Joujo1/behaviour_bmi/bmi_closed_loop/bin_viewer.py

#!/usr/bin/env python3
"""
Standalone .bin file viewer for BMI closed-loop recordings.

Opens a browser-based file browser rooted at NAS_BASE_PATH.
Select any .bin file to view a Verilog-style waveform of all GPIO signals,
with state/substage annotations and a small JPEG preview.

Usage:
    python bin_viewer.py [--port 7000] [--root /path/to/NAS]

Then open http://localhost:7000 in a browser.
"""

import argparse
import io
import json
import os
import struct
import sys

from flask import Flask, abort, jsonify, make_response, render_template, request, send_file

# ── Packet format (must match udp_sender_pi.py and packet_parser.py) ─────────

HEADER_FORMAT = "<IQIIBBBBBBBBB"
HEADER_SIZE   = struct.calcsize(HEADER_FORMAT)
HEADER_FIELDS = [
    "pi_seq", "timestamp", "jpeg_size", "events_size",
    "led_center", "led_left", "led_right",
    "valve_left", "valve_right",
    "beam_left", "beam_right", "beam_center",
    "trial_state",
]

GPIO_SIGNALS = [
    ("led_left",    "LED L",   False),
    ("led_center",  "LED C",   False),
    ("led_right",   "LED R",   False),
    ("beam_left",   "Beam L",  True),
    ("beam_center", "Beam C",  True),
    ("beam_right",  "Beam R",  True),
    ("valve_left",  "Valve L", False),
    ("valve_right", "Valve R", False),
    ("clicks",      "Clicks",  False),
]

# ── Bin file indexing ─────────────────────────────────────────────────────────

def index_bin(path: str) -> tuple:
    """
    Parse headers and events for every frame.
    Returns (frames, state_changes, timeline).
    """
    index         = []
    current_state = None
    state_changes = []
    raw_timeline  = []
    last_kf_idx   = 0

    with open(path, "rb") as f:
        while True:
            length_bytes = f.read(4)
            if len(length_bytes) < 4:
                break
            packet_len   = struct.unpack("<I", length_bytes)[0]
            packet_start = f.tell()
            packet       = f.read(packet_len)

            if len(packet) < packet_len:
                break

            header_vals = struct.unpack(HEADER_FORMAT, packet[:HEADER_SIZE])
            header      = dict(zip(HEADER_FIELDS, header_vals))
            events_size = header["events_size"]
            jpeg_size   = header["jpeg_size"]

            events = []
            if events_size > 0:
                try:
                    events = json.loads(packet[HEADER_SIZE : HEADER_SIZE + events_size])
                except Exception:
                    pass

            frame_idx  = len(index)
            img_start  = HEADER_SIZE + events_size
            img_header = packet[img_start : img_start + 5]
            is_h264    = img_header[:4] == b'\x00\x00\x00\x01'
            if is_h264 and len(img_header) == 5 and (img_header[4] & 0x1F) == 7:
                last_kf_idx = frame_idx

            for e in events:
                if "to" in e:
                    current_state = e["to"]
                    state_changes.append(frame_idx)
                    raw_timeline.append({
                        "frame": frame_idx,
                        "state": current_state,
                        "t":     round(e.get("t", 0), 3),
                        "from":  e.get("from", "—"),
                    })

            index.append({
                "header":            header,
                "events":            events,
                "jpeg_offset":       packet_start + HEADER_SIZE + events_size,
                "jpeg_size":         jpeg_size,
                "current_state":     current_state,
                "is_h264":           is_h264,
                "last_keyframe_idx": last_kf_idx,
            })

    TERMINALS = {"__correct__", "__wrong__", "__end__", "aborted"}

    for i, (change_frame, tl) in enumerate(zip(state_changes, raw_timeline)):
        from_state  = tl["from"]
        block_start = state_changes[i - 1] if i > 0 else 0
        for k in range(block_start, change_frame):
            if index[k]["current_state"] is None or \
               index[k]["current_state"] in TERMINALS:
                index[k]["current_state"] = from_state

    # Group transitions into trials.
    # Two split conditions:
    #   1. Terminal state reached (__correct__, __wrong__, __end__, aborted).
    #   2. t decreases — the engine restarted (new trial_start), so the terminal
    #      event was never flushed into the stream before fsm_data_cb changed.
    trials_raw    = []
    current_trial = []
    prev_t        = None
    for tl in raw_timeline:
        if current_trial and prev_t is not None and tl["t"] < prev_t:
            trials_raw.append(current_trial)
            current_trial = []
        current_trial.append(tl)
        prev_t = tl["t"]
        if tl["state"] in TERMINALS:
            trials_raw.append(current_trial)
            current_trial = []
            prev_t = None
    if current_trial:
        trials_raw.append(current_trial)

    # Build rich timeline
    timeline   = []
    nav_frames = []

    for trial_idx, transitions in enumerate(trials_raw):
        first_transition_frame = transitions[0]["frame"]
        initial_state = transitions[0]["from"]

        trial_start_frame = first_transition_frame
        for k in range(first_transition_frame - 1, -1, -1):
            if index[k]["current_state"] == initial_state:
                trial_start_frame = k
            else:
                break

        # Compute trial_start in absolute µs from the first transition event.
        # trial_start_us = frame_timestamp - event_t_seconds * 1e6
        first_tr   = transitions[0]
        trial_start_us = (index[first_tr["frame"]]["header"]["timestamp"]
                          - int(first_tr["t"] * 1_000_000))
        frame_end = (trials_raw[trial_idx + 1][0]["frame"]
                     if trial_idx + 1 < len(trials_raw) else len(index))
        for k in range(trial_start_frame, frame_end):
            index[k]["trial_start_us"] = trial_start_us

        timeline.append({"type": "trial_header", "trial_num": trial_idx + 1,
                          "frame": trial_start_frame})
        nav_frames.append(trial_start_frame)

        prev_t     = 0.0
        prev_frame = trial_start_frame

        for tl in transitions:
            timeline.append({
                "type":     "state",
                "state":    tl["from"],
                "frame":    prev_frame,
                "start_t":  prev_t,
                "duration": round(tl["t"] - prev_t, 3),
            })
            nav_frames.append(prev_frame)
            timeline.append({
                "type":       "transition",
                "from_state": tl["from"],
                "to_state":   tl["state"],
                "t":          tl["t"],
                "frame":      tl["frame"],
            })
            nav_frames.append(tl["frame"])
            prev_t     = tl["t"]
            prev_frame = tl["frame"]

        last = transitions[-1]
        timeline.append({
            "type":     "state",
            "state":    last["state"],
            "frame":    last["frame"],
            "start_t":  last["t"],
            "duration": None,
        })
        nav_frames.append(last["frame"])

        if trial_idx < len(trials_raw) - 1:
            next_first_frame = trials_raw[trial_idx + 1][0]["frame"]
            ts_end  = index[last["frame"]]["header"]["timestamp"]
            ts_next = index[next_first_frame]["header"]["timestamp"]
            gap_s   = round((ts_next - ts_end) / 1_000_000, 1)
            iti_outcome = ("correct" if last["state"] in ("__correct__", "__end__")
                           else "wrong" if last["state"] == "__wrong__"
                           else "unknown")
            timeline.append({"type": "iti", "duration_s": gap_s,
                              "frame": last["frame"], "next_frame": next_first_frame,
                              "outcome": iti_outcome})

    nav_frames = sorted(set(nav_frames))
    return index, nav_frames, timeline


# ── Waveform data builder ─────────────────────────────────────────────────────

def build_waveform(frames: list) -> dict:
    """
    Build event-driven waveform data.
    Output/beam signals use precise event timestamps (sub-frame accuracy).
    Returns dict with:
      - t_us: list of frame timestamps (µs from recording start)
      - signals: {signal_name: {"xs_us": [...], "ys": [...]}}  (step functions)
      - state_labels: [{t_us, state, frame}]
    """
    t0   = frames[0]["header"]["timestamp"] if frames else 0
    t_us = [f["header"]["timestamp"] - t0 for f in frames]

    BEAM_KEYS   = {"beam_left", "beam_center", "beam_right"}
    OUTPUT_KEYS = {"led_left", "led_center", "led_right",
                   "valve_left", "valve_right", "clicks"}

    # Seed initial state: beams from first header, outputs all off
    cur = {}
    for sig in BEAM_KEYS:
        cur[sig] = frames[0]["header"][sig] if frames else 0
    for sig in OUTPUT_KEYS:
        cur[sig] = 0

    # Collect (t_us_from_t0, state) pairs per signal from events
    sig_pts = {sig: [(0, cur[sig])] for sig in cur}

    for frame in frames:
        tsu = frame.get("trial_start_us")
        if tsu is None:
            continue
        for ev in frame["events"]:
            if "output" in ev:
                sig = ev["output"]
                if sig in sig_pts:
                    t = int(tsu + ev["t"] * 1_000_000) - t0
                    sig_pts[sig].append((t, 1 if ev["active"] else 0))
            elif "sensor" in ev:
                sig = f"beam_{ev['sensor']}"
                if sig in sig_pts:
                    t = int(tsu + ev["t"] * 1_000_000) - t0
                    sig_pts[sig].append((t, 1 if ev["active"] else 0))

    # Build step-function xs/ys: insert duplicate x at each transition for vertical edge
    signals = {}
    for sig, pts in sig_pts.items():
        pts.sort(key=lambda p: p[0])
        xs, ys = [], []
        for i, (t, v) in enumerate(pts):
            if i > 0 and pts[i - 1][1] != v:
                xs.append(t); ys.append(pts[i - 1][1])
            xs.append(t); ys.append(v)
        signals[sig] = {"xs_us": xs, "ys": ys}

    state_labels = []
    prev_state   = None
    for i, f in enumerate(frames):
        cs = f["current_state"]
        if cs != prev_state:
            state_labels.append({"t_us": t_us[i], "state": cs or "—", "frame": i})
            prev_state = cs

    return {
        "t_us":         t_us,
        "signals":      signals,
        "state_labels": state_labels,
    }


# ── Stats ─────────────────────────────────────────────────────────────────────

def compute_stats(wf: dict) -> dict:
    """Count trial outcomes from state transition labels."""
    correct = sum(1 for sl in wf["state_labels"] if sl["state"] == "__correct__")
    wrong   = sum(1 for sl in wf["state_labels"] if sl["state"] == "__wrong__")
    decided = correct + wrong
    return {
        "n_trials":    decided,
        "correct":     correct,
        "wrong":       wrong,
        "success_pct": round(100 * correct / decided, 1) if decided else None,
    }


# ── Plotly figure builder ─────────────────────────────────────────────────────

def build_figure(frames: list, wf: dict) -> dict:
    """
    Build a Plotly-compatible figure dict for the waveform.
    shapes[0] is reserved as the cursor line (initially hidden).
    State background blocks start at shapes[1].
    """
    t_s = [t / 1_000_000 for t in wf["t_us"]]
    N   = len(GPIO_SIGNALS)

    COLORS = {"led": "#3b82f6", "valve": "#f59e0b", "beam": "#ef4444", "clicks": "#8b5cf6"}

    traces    = []
    tick_vals = []
    tick_text = []

    for idx, (key, label, is_beam) in enumerate(GPIO_SIGNALS):
        offset = (N - 1 - idx) * 1.8
        tick_vals.append(offset + 0.5)
        tick_text.append(label)
        color = (COLORS["beam"]   if is_beam else
                 COLORS["valve"]  if "valve"  in key else
                 COLORS["clicks"] if key == "clicks" else
                 COLORS["led"])

        sig   = wf["signals"].get(key, {"xs_us": [0], "ys": [0]})
        xs    = [x / 1_000_000 for x in sig["xs_us"]]
        ys    = [y + offset     for y in sig["ys"]]

        traces.append({
            "type":       "scatter",
            "x":          xs,
            "y":          ys,
            "name":       label,
            "mode":       "lines",
            "line":       {"color": color, "width": 1.5},
            "hoverinfo":  "skip",
            "showlegend": False,
        })

    # shapes[0]: cursor line   — updated by JS on click/nav
    # shapes[1]: state highlight — updated by JS when active state changes
    shapes = [
        {
            "type": "line", "xref": "x", "yref": "paper",
            "x0": t_s[0], "x1": t_s[0], "y0": 0, "y1": 1,
            "line": {"color": "rgba(255,100,0,0.85)", "width": 2, "dash": "solid"},
            "visible": False,
        },
        {
            "type": "rect", "xref": "x", "yref": "paper",
            "x0": t_s[0], "x1": t_s[0], "y0": 0, "y1": 1,
            "fillcolor": "rgba(0,0,0,0)",
            "line": {"color": "rgba(255,160,0,0.9)", "width": 2},
            "layer": "above",
            "visible": False,
        },
    ]

    # State background blocks
    labels = wf["state_labels"]
    for i, sl in enumerate(labels):
        t0    = sl["t_us"] / 1_000_000
        t1    = labels[i + 1]["t_us"] / 1_000_000 if i + 1 < len(labels) else t_s[-1]
        state = sl["state"] or "—"
        color = ("rgba(64,202,114,0.18)"  if state == "__correct__" else
                 "rgba(205,20,20,0.14)"   if state == "__wrong__"   else
                 "rgba(240,240,240,0.55)")
        shapes.append({
            "type": "rect", "xref": "x", "yref": "paper",
            "x0": t0, "x1": t1, "y0": 0, "y1": 1,
            "fillcolor": color, "line": {"width": 0}, "layer": "below",
        })


    layout = {
        "shapes": shapes,
        "xaxis": {
            "title":     "Time from recording start (s)",
            "zeroline":  False,
            "showgrid":  True,
            "gridcolor": "#e8e8e8",
        },
        "yaxis": {
            "tickvals":   tick_vals,
            "ticktext":   tick_text,
            "zeroline":   False,
            "showgrid":   False,
            "range":      [-0.3, N * 1.8 - 0.2],
            "fixedrange": True,
        },
        "margin":        {"l": 80, "r": 10, "t": 10, "b": 60},
        "showlegend":    False,
        "hovermode":     "x",
        "plot_bgcolor":  "#fff",
        "paper_bgcolor": "#fff",
        "autosize":      True,
        "dragmode":      "pan",
    }

    return {"data": traces, "layout": layout}


# ── Flask app ─────────────────────────────────────────────────────────────────

_cache = {}   # rel_path -> (frames, timeline, waveform)

def _load(rel: str, root: str):
    if rel in _cache:
        return _cache[rel]
    abs_path = os.path.realpath(os.path.join(root, rel))
    if not abs_path.startswith(os.path.realpath(root)):
        raise ValueError("path outside root")
    frames, nav_frames, tl = index_bin(abs_path)
    wf = build_waveform(frames)
    _cache[rel] = (abs_path, frames, tl, wf)
    return _cache[rel]


def create_app(root: str) -> Flask:
    root     = os.path.realpath(root)
    tmpl_dir = os.path.join(os.path.dirname(os.path.abspath(__file__)), "templates")
    app      = Flask(__name__, template_folder=tmpl_dir)

    @app.get("/")
    def index():
        return render_template("bin_viewer.html")

    @app.get("/api/browse")
    def api_browse():
        rel     = request.args.get("path", "")
        abs_dir = os.path.realpath(os.path.join(root, rel))
        if not abs_dir.startswith(root):
            abort(403)
        if not os.path.isdir(abs_dir):
            abort(404)

        items = []
        try:
            for name in sorted(os.listdir(abs_dir)):
                full = os.path.join(abs_dir, name)
                rel2 = os.path.relpath(full, root)
                if os.path.isdir(full):
                    items.append({"type": "dir", "name": name, "rel": rel2})
                elif name.endswith(".bin"):
                    items.append({"type": "file", "name": name,
                                   "rel": rel2, "size": os.path.getsize(full)})
        except PermissionError:
            pass

        parent = None
        if abs_dir != root:
            p = os.path.relpath(os.path.dirname(abs_dir), root)
            parent = "" if p == "." else p

        return jsonify({"abs_path": abs_dir, "items": items, "parent": parent})

    @app.get("/api/figure")
    def api_figure():
        rel = request.args.get("path", "")
        try:
            abs_path, frames, _, wf = _load(rel, root)
        except Exception as e:
            return str(e), 400
        return jsonify(build_figure(frames, wf))

    @app.get("/api/stats")
    def api_stats():
        rel = request.args.get("path", "")
        try:
            _, _, _, wf = _load(rel, root)
        except Exception as e:
            return str(e), 400
        return jsonify(compute_stats(wf))

    @app.get("/api/waveform")
    def api_waveform():
        rel = request.args.get("path", "")
        try:
            _, _, _, wf = _load(rel, root)
        except Exception as e:
            return str(e), 400
        return jsonify(wf)

    @app.get("/api/timeline")
    def api_timeline():
        rel = request.args.get("path", "")
        try:
            _, _, tl, _ = _load(rel, root)
        except Exception as e:
            return str(e), 400
        return jsonify(tl)

    @app.get("/api/frame/image")
    def api_frame_image():
        rel   = request.args.get("path", "")
        frame = request.args.get("frame", 0, type=int)
        try:
            abs_path, frames, _, _ = _load(rel, root)
        except Exception as e:
            return str(e), 400
        if not (0 <= frame < len(frames)):
            abort(404)
        f = frames[frame]

        if not f["is_h264"]:
            with open(abs_path, "rb") as fh:
                fh.seek(f["jpeg_offset"])
                img_bytes = fh.read(f["jpeg_size"])
            return send_file(io.BytesIO(img_bytes), mimetype="image/jpeg")

        # H264: return framed NAL sequence from last keyframe through target frame.
        # Format per frame: [4-byte LE NAL length][1-byte keyframe flag][NAL bytes]
        # Client uses WebCodecs to decode and renders the last frame.
        key_idx = f["last_keyframe_idx"]
        buf = io.BytesIO()
        with open(abs_path, "rb") as fh:
            for i in range(key_idx, frame + 1):
                fi = frames[i]
                fh.seek(fi["jpeg_offset"])
                nal = fh.read(fi["jpeg_size"])
                is_key = i == key_idx
                buf.write(struct.pack("<IB", len(nal), 1 if is_key else 0))
                buf.write(nal)
        buf.seek(0)
        response = make_response(send_file(buf, mimetype="application/octet-stream"))
        response.headers["X-Codec"] = "h264"
        return response

    return app


def main():
    import logging
    logging.getLogger("werkzeug").setLevel(logging.ERROR)

    try:
        from config import NAS_BASE_PATH
        default_root = NAS_BASE_PATH
    except ImportError:
        default_root = os.path.expanduser("~")

    parser = argparse.ArgumentParser(description="BMI bin file viewer")
    parser.add_argument("--port", type=int, default=7000, help="Local port (default 7000)")
    parser.add_argument("--root", default=default_root,
                        help=f"Root directory to browse (default: {default_root})")
    args = parser.parse_args()

    if not os.path.isdir(args.root):
        print(f"Root directory does not exist: {args.root}", file=sys.stderr)
        sys.exit(1)

    app = create_app(args.root)
    print(f"Bin Viewer  →  http://localhost:{args.port}")
    print(f"Browsing    →  {args.root}")
    app.run(host="0.0.0.0", port=args.port, threaded=True)


if __name__ == "__main__":
    main()
