Joujo1/behaviour_bmi/bmi_closed_loop/pps_log.c

#include <stdio.h>
#include <stdlib.h>
#include <fcntl.h>
#include <unistd.h>
#include <time.h>
#include <errno.h>
#include <string.h>
#include <timepps.h>

int main(void)
{
    int fd = open("/dev/pps0", O_RDWR);
    if (fd < 0) { perror("open /dev/pps0"); return 1; }

    pps_handle_t handle;
    if (time_pps_create(fd, &handle) < 0) {
        perror("time_pps_create"); return 1;
    }

    int cap = 0;
    time_pps_getcap(handle, &cap);
    if (!(cap & PPS_CAPTUREASSERT)) {
        fprintf(stderr, "Device cannot capture assert edge\n"); return 1;
    }

    pps_params_t params;
    time_pps_getparams(handle, &params);
    params.mode |= PPS_CAPTUREASSERT | PPS_TSFMT_TSPEC;
    time_pps_setparams(handle, &params);

    printf("%-20s  %-20s  %s\n",
           "pps_realtime_ns", "monotonic_ns", "seq");

    struct timespec timeout = { .tv_sec = 3, .tv_nsec = 0 };
    pps_info_t info;
    unsigned int last_seq = 0;

    while (1) {
        int ret = time_pps_fetch(handle, PPS_TSFMT_TSPEC, &info, &timeout);
        if (ret < 0) { perror("pps_fetch"); continue; }

        if (info.assert_sequence == last_seq) continue;
        last_seq = info.assert_sequence;

        // Read both clocks back-to-back so their offset is accurate.
        // With NTP disabled, rt - mono is constant throughout the run,
        // letting us project the kernel PPS realtime stamp onto MONOTONIC.
        struct timespec rt_now, mono_now;
        clock_gettime(CLOCK_REALTIME,  &rt_now);
        clock_gettime(CLOCK_MONOTONIC, &mono_now);

        long long pps_rt_ns  = (long long)info.assert_timestamp.tv_sec * 1000000000LL
                             + info.assert_timestamp.tv_nsec;
        long long rt_now_ns  = (long long)rt_now.tv_sec  * 1000000000LL + rt_now.tv_nsec;
        long long mono_now_ns= (long long)mono_now.tv_sec* 1000000000LL + mono_now.tv_nsec;

        // CLOCK_MONOTONIC equivalent at the exact PPS edge
        long long mono_at_edge = pps_rt_ns - (rt_now_ns - mono_now_ns);

        printf("%-20lld  %-20lld  %u\n", pps_rt_ns, mono_at_edge, last_seq);
        fflush(stdout);
    }

    time_pps_destroy(handle);
    close(fd);
    return 0;
}
