Joujo1/behaviour_bmi/bmi_closed_loop/RPi_main/click_test.py

"""
    python click_test.py                          # 10 clicks/s mono
    python click_test.py --rate 5                 # 5 clicks/s mono
    python click_test.py --ici 0.2                # 200 ms ICI mono
    python click_test.py --left 40 --right 10     # stereo Poisson
"""

import argparse

import numpy as np
import sounddevice as sd

from audio import build_click, SRATE

BUFFER_S = 2.0                          # seconds of audio pre-generated per chunk


def generate_poisson_buffer(click: np.ndarray, left_rate: float,
                             right_rate: float, duration: float,
                             min_ici: float = 0.0):
    """Generate a stereo buffer with independent Poisson click trains per channel."""
    n_samples = int(duration * SRATE)
    buf = np.zeros((n_samples, 2), dtype=np.float32)
    click_len = len(click)
    times = [[], []]

    for ch, rate in enumerate([left_rate, right_rate]):
        t = 0.0
        last_t = -np.inf
        dropped = 0
        while t < duration:
            t += np.random.exponential(1.0 / rate)
            if t - last_t < min_ici:
                dropped += 1
                continue
            i = int(t * SRATE)
            if i + click_len <= n_samples:
                buf[i:i + click_len, ch] += click
                times[ch].append(round(t, 4))
                last_t = t
        if dropped:
            print(f"  ch{'LR'[ch]}: dropped {dropped} clicks (min_ici={min_ici*1000:.1f}ms)")

    np.clip(buf, -1.0, 1.0, out=buf)
    return buf, times[0], times[1]


def main():
    parser = argparse.ArgumentParser()
    mono_group = parser.add_mutually_exclusive_group()
    mono_group.add_argument("--rate", type=float, default=None,
                            help="mono clicks per second (default 10)")
    mono_group.add_argument("--ici",  type=float,
                            help="mono inter-click interval in seconds")
    parser.add_argument("--left",    type=float, default=None,
                        help="left channel Poisson rate (clicks/s)")
    parser.add_argument("--right",   type=float, default=None,
                        help="right channel Poisson rate (clicks/s)")
    parser.add_argument("--seconds", type=float, default=1.0,
                        help="trial duration in seconds (default 1.0)")
    parser.add_argument("--gap",     type=float, default=0.0,
                        help="silence between trials in seconds (default 0)")
    parser.add_argument("--shuffle",  type=int,   default=0,
                        help="if 1, randomly swap left/right each trial")
    parser.add_argument("--min-ici", type=float, default=0.0,
                        help="minimum inter-click interval in seconds (drops overlapping clicks)")
    args = parser.parse_args()

    click = build_click()
    stereo_mode = args.left is not None or args.right is not None

    if stereo_mode:
        duration   = args.seconds
        left_rate  = args.left  or 0.0
        right_rate = args.right or 0.0
        print(f"Stereo Poisson — left: {left_rate:.1f} Hz  right: {right_rate:.1f} Hz  "
              f"duration: {duration:.1f}s  (expected ~{left_rate*duration:.0f}L / {right_rate*duration:.0f}R clicks)")
        print("Playing — Ctrl+C to stop\n")

        gap_samples = int(args.gap * SRATE)
        silence = np.zeros((gap_samples, 2), dtype=np.float32)

        try:
            with sd.OutputStream(samplerate=SRATE, channels=2,
                                  device=1, dtype='float32') as stream:
                trial = 0
                while True:
                    trial += 1
                    l, r = left_rate, right_rate
                    if args.shuffle and np.random.randint(2):
                        l, r = r, l
                        side = "R>L"
                    else:
                        side = "L>R"
                    buf, left_times, right_times = generate_poisson_buffer(click, l, r, duration, args.min_ici)
                    print(f"Trial {trial} [{side}]  L={len(left_times)} clicks: {[f'{t:.3f}' for t in left_times]}")
                    print(f"              R={len(right_times)} clicks: {[f'{t:.3f}' for t in right_times]}")
                    stream.write(buf)
                    if gap_samples:
                        stream.write(silence)
        except KeyboardInterrupt:
            print("\nStopped.")

    else:
        ici = args.ici if args.ici is not None else 1.0 / (args.rate or 10.0)
        print(f"Mono — rate: {1/ici:.1f} clicks/s  ICI: {ici*1000:.0f} ms")
        print("Playing — Ctrl+C to stop\n")

        ici_samples = int(round(ici * SRATE))
        period = np.zeros(ici_samples, dtype=np.float32)
        period[:len(click)] = click

        try:
            with sd.OutputStream(samplerate=SRATE, channels=1,
                                  device=1, dtype='float32') as stream:
                while True:
                    stream.write(period)
        except KeyboardInterrupt:
            print("\nStopped.")


if __name__ == "__main__":
    main()
