Joujo1/behaviour_bmi/(commit log)

2024-08-05 log_ephys button
2025-01-17 maxwell proc buttons, nas check
2025-02-12 all+ephys laun ch button
2025-07-21 animalw analytics, spikes-postproc, brain area, P000 loading, cue corr heatm, ensambles, session_wf plot, env yml
2026-01-23 kinematics fixes
2026-02-18 cam for DLC,hmm,kinematics fixes
2026-03-16 pose est,Rat9,10,nonAbsAcc,sessionIDint-hack,kinematicsPlotFixes,notebooks
2026-03-16 devicepaths reroute to baseVR
2026-04-04 Builder seperate, frame and gpio coupling, metrics
    [transactions.csv]
2026-04-13 led strip and fan
2026-04-14 UI changes, PWM for fan
2026-04-14 fixed automatic advacement bugs
    [config.py, streamer.py]
2026-04-17 Add log entries for camera streaming events
    Log entries for starting and stopping camera streaming.
2026-04-19 Corrected timestamps of events
    [actions.py, bin_viewer.py, engine.py]
2026-04-19 scoresheet prototype
2026-04-28 Added I and P frame size debug print statement
2026-04-28 frame alignment correction
2026-05-06 changes to audio device
2026-05-07 debug print
2026-05-07 added gpio pwm test
2026-05-11 Added Side Bias prototype
2026-05-14 hold timer
2026-05-21 live substage switch per subjects page
2026-05-24 code framework rework
2026-05-25 fixed validation variables for kernel tunings
    [main.py]
2026-05-27 fiixed stuck high bug
    [actions.py]
2026-05-31 removed 1 frame correction
    [streamer.py]
2026-06-02 add per-frame timestamp CSV logging for fps stability testing
